sabinoj/NCF-RFID-Door-Control-Prototype/PCB/Project Outputs for UNOshield/RFID_Project_GrayV1.xlsx

Comment | Description | Designator | Footprint | LibRef | Quantity | Supplier 1 | Supplier 2 | Supplier 3 | Supplier 4 | Supplier 5 | Supplier Part Number 1 | Supplier Part Number 2 | Supplier Part Number 3 | Supplier Part Number 4 | Supplier Part Number 5
54-00164 | Power Barrel Connector Jack 2.10mm ID (0.083"), 5.50mm OD (0.217") Surface Mount, Right Angle | 24V_Barrel | 54-00164 | 54-00164 | 1 | Digikey |  |  |  |  | 839-54-00164CT-ND
 | Board Connector, 50 Contact(s), 1 Row(s), Male, Straight, 0.1 inch Pitch, Solder Terminal, Black Insulator, Receptacle | ALL_MALE_HEADERS | HDR1X2 | Header 2 | 1 | Digikey |  |  |  |  | SAM1029-50-ND
SMT-0823-S-R | Audio Indicator Transducer Electromagnetic 5Vp-p 70mA Solder Pad 3Vp-p 1800Hz to 2800Hz Surface Mount | BZ1 | XDCR_SMT-0823-S-R | SMT-0823-S-R | 1 | Digikey |  |  |  |  | 668-1066-1-ND
Bypass Capacitor | CAP CER 0.1UF 10V X7R 0603 | C1, C2 | FP-CC0603-DA-MFG | CMP-03422-001228-1 | 2 | Digikey |  |  |  |  | 311-4055-1-ND
LS R976-NR-1 | LED RED DIFFUSED 0805 SMD | D1 | FP-LS_R976-MFG | CMP-62016-000037-1 | 1 | Digi-Key |  |  |  |  | 475-LSR976-NR-1CT-ND
LTST-C191KGKT |  | D2 | FP-LTST-C191KGKT-MFG | CMP-2000-05198-4 | 1 | Digikey |  |  |  |  | 160-1446-1-ND
1N4148WS-7-F | Fast Switching Diode, 75 V, 0.3 A, -65 to 150 degC, 2-Pin SOD323, RoHS, Tape and Reel | D3, D4 | DIOD-SOD323-2-A_V | CMP-1667-00004-1 | 2 | Digikey |  |  |  |  | 1N4148WS-FDICT-ND
Header 2 | Board Connector, 2 Contact(s), 1 Row(s), Female, Straight, 0.1 inch Pitch, Solder Terminal, Black Insulator, Socket | Door_Act, Door_Sensor | HDR1X2 | Header 2 | 2 | Digikey |  |  |  |  | SAM12477-ND
Header 5X2 | Board Connector, 66 Contact(s), 2 Row(s), Male, Straight, Solder Terminal | EM4095_EXT | HDR2X5 | Header 5X2 | 1 | Digikey |  |  |  |  | 609-3243-ND
AD |  | H_AD | Header 6x1 8.5mm | AD | 1 | Arrow | Digi-Key | Arrow | Arrow |  | 2699089 | SAM1198-06-ND | 2699088 | 2699075
IOH |  | H_IOH | Header 10x1 8.5mm | IOH | 1 | Arrow | Digi-Key | Arrow |  |  | 2698803S4475693N1004 | SAM1198-10-ND | 2698789
IOL, POWER_UNO |  | H_IOL, H_PWR | Header 8x1 8.5mm | IOL, POWER_UNO | 2 | Digi-Key | Arrow | Arrow | Arrow |  | SAM1198-08-ND | 2698939 | 2698940 | 2698925
1462041-7 | RELAY TELECOM SPST 2A 5VDC | K1 | FP-1462041-7-MFG | CMP-03396-000009-1 | 1 | Digikey |  |  |  |  | PB1247CT-ND
Header 5 | Header, 5-Pin | LCD | HDR1X5 | Header 5 | 1
 | I2C/Spi Character Lcd Backpack - Stemma Qt/Qwiic Rohs Compliant: Yes |Adafruit 292 | LCD_BACKPACK | HDR1X5 | Header 5 | 1 | Digikey |  |  |  |  | 1528-1446-ND
 | Standard LCD 16x2 + extras - white on blue | Adafruit Industries 181 | LCD_Screen | HDR1X5 | Header 5 | 1 | Digikey |  |  |  |  | 1528-181-ND
 | .093IN Pwr Connector Kit Single Row Panel Mnt Plug & Recept; 4 Ckt | MOLEX_CONNECTOR | HDR1X2 | Header 2 | 1 | Digikey |  |  |  |  | 23-0766500059-ND
PYQ_1548/7660 | Low Power Digipyro Motion Sens | Motion_Sensor | TO254P940H440-4 | PYQ_1548/7660 | 1 | Digikey |  |  |  |  | 1601-1008-ND
NX7002AK,215 | Single N-Channel Trench MOSFET, 60 V, -55 to 150 degC, 3-Pin SOT23, Tape and Reel | Q1, Q2 | NXP-SOT23_L | CMP-1258-00137-1 | 2 | Digikey |  |  |  |  | 1727-1289-1-ND
Optional, [NoValue] | SMD Chip Resistor, 120 Ohm, ± 5%, 250 mW, 0603 [1608 Metric], Thick Film, Anti-Surge | R1, R2 | 1608[0603] | Res1 | 2 | Digikey |  |  |  |  | P120BZCT-ND
RMCF1206FT10R0 | RES 10 OHM 1% 1/4W 1206 | R3, R4 | FP-RMCF1206-IPC_C | CMP-26527-000112-1 | 2 | Digikey |  |  |  |  | RMCF1206FT10R0CT-ND
10k | RES 10K OHM 1% 1/10W 0603 | RD | FP-RC0603-0_55-IPC_C | CMP-2100-03664-2 | 1 | Digikey |  |  |  |  | RMCF0603FT10K0CT-ND
Res1 | Fixed Resistor, Metal Glaze/thick Film, 0.125W, 150ohm, 150V, 1% +/-Tol, 100ppm/Cel, Surface Mount, 0805 | RG, RR | C0805 | Res1 | 2 | Digikey |  |  |  |  | 311-150CRCT-ND
 | Cable Assembly, 28AWG | Ribbon_Cable | HDR2X5 | Header 5X2 | 1 | Digikey |  |  |  |  | IDSD-05-D-12.00-T-G-ND
 | Telecom and Datacom Connector | RJ45 | 1-1775365-4 | Header 9 | 1 | Digikey |  |  |  |  | 17-1-1775365-4CT-ND
MAX490ESA | Line Transceiver, 1 Func, 1 Driver, 1 Rcvr, CMOS, PDSO8 | U1 | SO-8_L | MAX490ESA | 1 | Digikey |  |  |  |  | MAX490ESA+-ND
