sabinoj/NCF-RFID-Door-Control-Prototype/3D_Models/SolidWorks_Assemblies/3D_Printed_Fixtures/RFID_Base_Fixture.SLDPRT

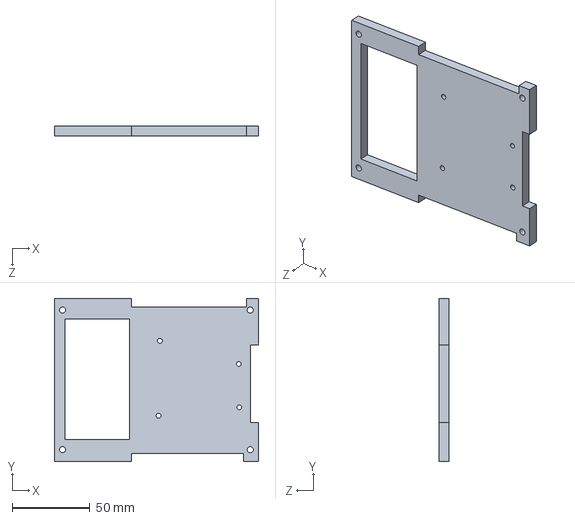
[picture p22: CAD file, 2025-08-13]
3D_Models/SolidWorks_Assemblies/3D_Printed_Fixtures/RFID_Base_Fixture.SLDPRT
131.5 x 105.1 x 6.35 mm
