sabinoj/NCF-RFID-Door-Control-Prototype/3D_Models/SolidWorks_Assemblies/3D_Printed_Fixtures/RFID_Top_Fixture.SLDPRT

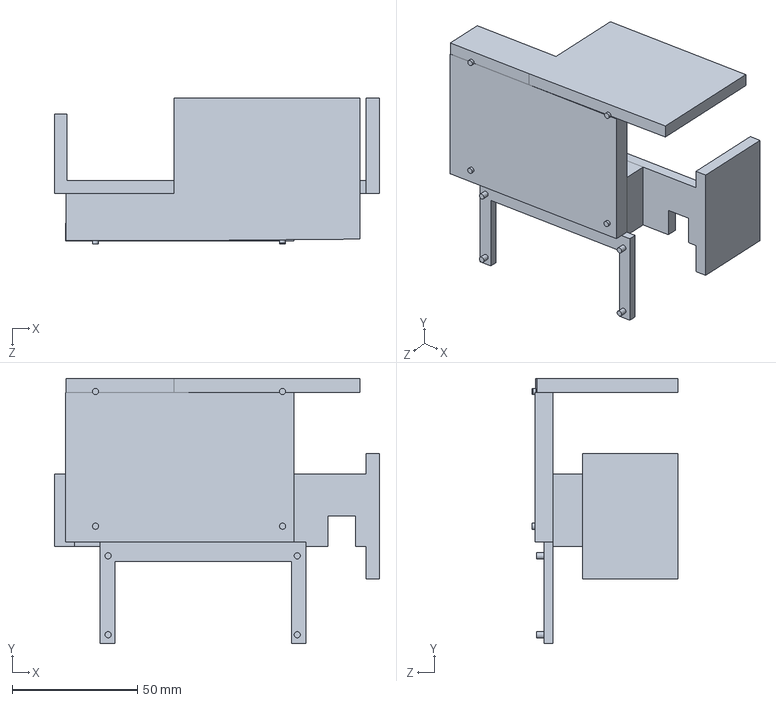
[picture p23: CAD file, 2025-08-13]
3D_Models/SolidWorks_Assemblies/3D_Printed_Fixtures/RFID_Top_Fixture.SLDPRT
129.8 x 105.8 x 58.3 mm
