sabinoj/NCF-RFID-Door-Control-Prototype/3D_Models/SolidWorks_Assemblies/Electronics/LCD_16X2.SLDPRT

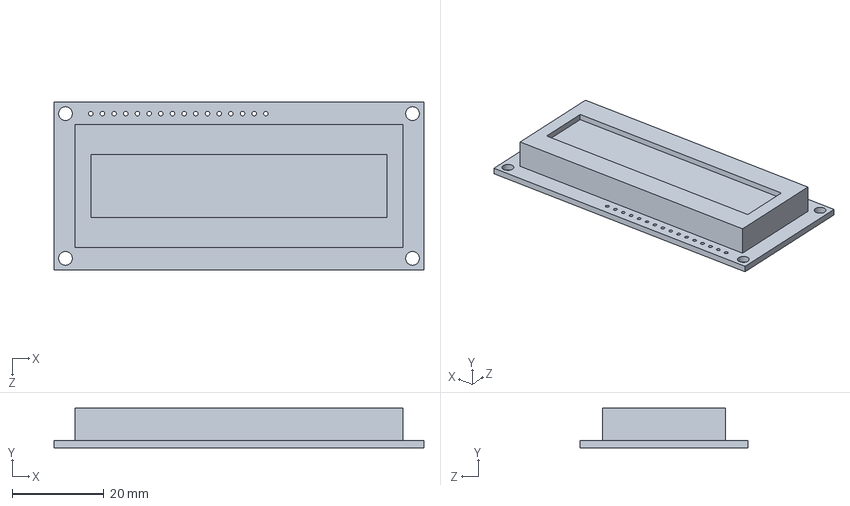
[picture p24: CAD file, 2025-08-13]
3D_Models/SolidWorks_Assemblies/Electronics/LCD_16X2.SLDPRT
80.5 x 8.70 x 36.5 mm
