sabinoj/NCF-RFID-Door-Control-Prototype/3D_Models/SolidWorks_Assemblies/Electronics/RFID_Board.SLDPRT

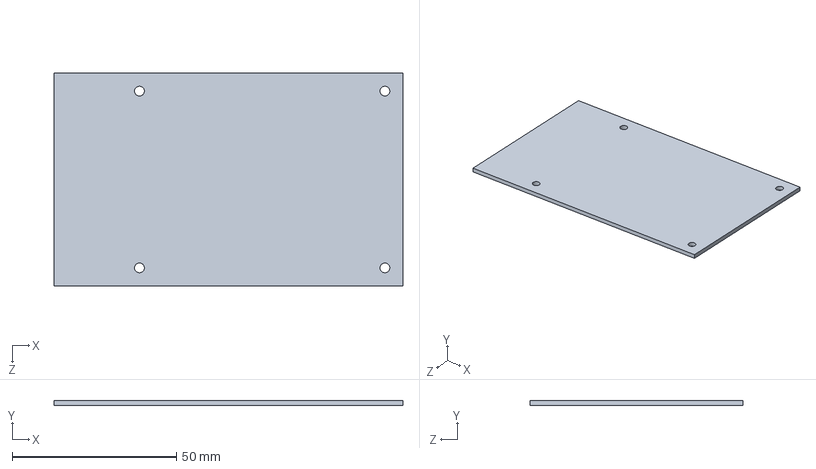
[picture p25: CAD file, 2025-08-13]
3D_Models/SolidWorks_Assemblies/Electronics/RFID_Board.SLDPRT
106.2 x 1.61 x 64.8 mm
