sabinoj/NCF-RFID-Door-Control-Prototype/(list of files, cad)

Other CAD files:
3D_Models/SolidWorks_Assemblies/Electronics/Adafruit I2C SPI LCD STEMMA backpack.SLDASM
3D_Models/STLs/RFID_Base_Plate.STL
3D_Models/STLs/RFID_Top_Plate.STL
