sabinoj/NCF-RFID-Door-Control-Prototype/(threads)

Thread 2 (2025-08-05):

PCB Design Revisions

sabinoj, 2025-08-05:
Found that the relay, K1, has pins 1 and 8 flipped for coil activation. A make-shift correction on the current verison has been made, but a revision is required on this design before I leave to guarantee a solid system.
