sabinoj/NCF-RFID-Door-Control-Prototype/(list of files, drawings)

Other design files:
PCB/Buzzer.SchDoc
PCB/Door_Actuator.SchDoc
PCB/EM4095.SchDoc
PCB/EM4095_OLD.SchDoc
PCB/LCD.SchDoc
PCB/MAX490.SchDoc
PCB/MAX490_Corrected_Symbol.SchLib
PCB/MIKROE262.SchDoc
PCB/RFID_Panel.PcbDoc
PCB/UNOshield.PcbDoc
PCB/UNOshield.PrjPcb
PCB/UNOshield.SchDoc
