sabinoj/NCF-RFID-Door-Control-Prototype/Arduino_Code/Computer_Module_Sim.ino

// formerly send_faux_data
// This is the code to simulate the computer module
void setup() {
  // put your setup code here,to run once:
  Serial.begin(19200);
  uint8_t Array1[33] = {254,86,2,254,86,5,254,87,1,254,86,4,254,88,32,82,70,73,68,45,84,82,83,32,82,101,97,100,121,32,254,71,255}; // Ready
  uint8_t Array2[22] = {254,66,1,254,88,73,110,97,99,116,105,118,101,32,85,115,101,114,33,254,87,3}; // Inactive
  uint8_t Array3[18] = {254,88,32,82,70,73,68,45,84,82,83,32,79,102,102,32,254,70}; // off
  uint8_t Array4[26] = {254,88,32,82,70,73,68,45,84,82,83,32,82,101,97,100,121,32,254,70,254,37,1,254,87,1}; // Ready
  uint8_t Array5[46] = {254,66,1,254,88,35,49,44,32,69,67,69,32,52,52,57,254,71,1,2,76,111,103,105,110,58,32,51,58,51,48,32,80,77,254,87,4,254,87,2,254,87,5,254,86,1}; // Login
  uint8_t Array6[38] = {254,66,1,254,88,35,49,44,32,69,67,69,32,52,52,57,254,71,1,2,76,111,103,111,117,116,58,32,51,58,51,49,32,80,77,254,87,2}; // Logout
  for(int i = 0; i < sizeof(Array1); i++){
   Serial.write(Array1[i]);
  }
}

void loop() {
  // put your main code here,to run repeatedly:
  // uint8_t Array1[23] = {254,86,2,254,88,32,82,70,73,68,45,84,82,83,32,82,101,97,100,121,32,254,70};
  // for(int i = 0; i < sizeof(Array1); i++){
  //  Serial.write(Array1[i]);
  // }
  // delay(2000);

  // uint8_t Array2[22] = {254,66,1,254,88,73,110,97,99,116,105,118,101,32,85,115,101,114,33,254,87,3};
  // for(int i = 0; i < sizeof(Array2); i++){
  //  Serial.write(Array2[i]);
  // }
  // delay(2000);

  // uint8_t Array3[18] = {254,88,32,82,70,73,68,45,84,82,83,32,79,102,102,32,254,70};
  // for(int i = 0; i < sizeof(Array3); i++){
  //  Serial.write(Array3[i]);
  // }
  // delay(2000);

  // uint8_t Array4[26] = {254,88,32,82,70,73,68,45,84,82,83,32,82,101,97,100,121,32,254,70,254,37,1,254,87,1};
  // for(int i = 0; i < sizeof(Array4); i++){
  //  Serial.write(Array4[i]);
  // }
  // delay(2000);

  // uint8_t Array5[46] = {254,66,1,254,88,35,49,44,32,69,67,69,32,52,52,57,254,71,1,2,76,111,103,105,110,58,32,51,58,51,48,32,80,77,254,87,4,254,87,2,254,87,5,254,86,1};
  // for(int i = 0; i < sizeof(Array5); i++){
  //  Serial.write(Array5[i]);
  // }
  // delay(2000);

  // uint8_t Array6[38] = {254,66,1,254,88,35,49,44,32,69,67,69,32,52,52,57,254,71,1,2,76,111,103,111,117,116,58,32,51,58,51,49,32,80,77,254,87,2};
  // for(int i = 0; i < sizeof(Array6); i++){
  //  Serial.write(Array6[i]);
  // }
  // delay(2000);
}
