sabinoj/NCF-RFID-Door-Control-Prototype/(commit log)

2025-05-15 Add files via upload
    This is Arduino code for simulating 2 way communication, supporting multiple profiles
2025-05-15 Add files via upload
    This is the arduino code that simulates various responses from the 2004 comp module
2025-06-25 Added the PCB design that I had on my workstation from the senior design group. I hope this is the correct design. Also, organized the respository for PCB designs and code.
    [EM4095.SchDoc, MAX490.SchDoc, MIKROE262.SchDoc, UNOshield.PcbDoc, UNOshield.PrjPcb, UNOshield.SchDoc]
2025-06-25 Updated the Arduino code to use the Adafruit LCD backpack unit over SPI to save on pins and allow for backlighting. Also, fixed a bug in the display when the system sees that the door is open.
    [NCF_Cleanroom_Reader_Code.ino]
2025-06-26 Arduino had to move the projects around so I needed to delete the old copy of the code.
2025-07-17 Updated the Arduino code to properly work with the legacy system. Tests show that the unit works properly. But further testing is encouraged.
2025-07-22 The revised prototype V2.0.0 PCB design is complete.
    [Buzzer.SchDoc, Door_Actuator.SchDoc, EM4095.SchDoc, EM4095_OLD.SchDoc, LCD.SchDoc, MAX490.SchDoc, MAX490_Corrected_Symbol.SchLib, UNOshield.PrjPcb]
2025-07-22 Created a panel to optimize the purchasing of boards. And the bill of material has been updated.
    [Buzzer.SchDoc, Door_Actuator.SchDoc, EM4095.SchDoc, MAX490.SchDoc, RFID_Panel.PcbDoc, UNOshield.SchDoc]
2025-07-22 Had to update the metadata file.
    [UNOshield.PrjPcb]
2025-07-23 Updated the code to now accept more of the original PC instructions, and I have included a timer system to turn the display off after a while. It has not been fully tested but is ready to check.
2025-07-23 Expanded the command codes so the system can now operate closely to the original system. And removed the timer system since it interferes with the buzzer. The buzzer has been set to operate at its re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
    [NCF_Cleanroom_Reader_Code.ino]
2025-07-25 Added the development board to the EM4095 schematic.
    [EM4095.SchDoc]
2025-08-13 Updated the code to accomodate for the Arduino being plugged in with the barrel jack with 9V. Also, this code has been modified for the new PCB in which the relay is normally closed so it needs to be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
    [NCF_Cleanroom_Reader_Code.ino]
2025-08-13 Updated the PCB design to correct a number of issues, and I included the gray box V1's (the current one) fabrication output zip files, and bill of materials.
    [Door_Actuator.SchDoc, MAX490.SchDoc, RFID_Project_GrayV1.xlsx]
2025-08-13 Updated the PCB to include a I2C connector for the LCD, and had to shift the text around a bit.
    [LCD.SchDoc]
2025-08-13 Adding the 3D models for the fixture of the housing.
    [Adafruit I2C SPI LCD STEMMA backpack.SLDASM, LCD_16X2.SLDPRT, RFID_Base_Fixture.SLDPRT, RFID_Base_Plate.STL, RFID_Board.SLDPRT, RFID_Top_Fixture.SLDPRT, RFID_Top_Plate.STL]
